paller/hat/wemos hat.kicad_pcb

## KiCad design wemos hat.kicad_pcb (2019-12-09)

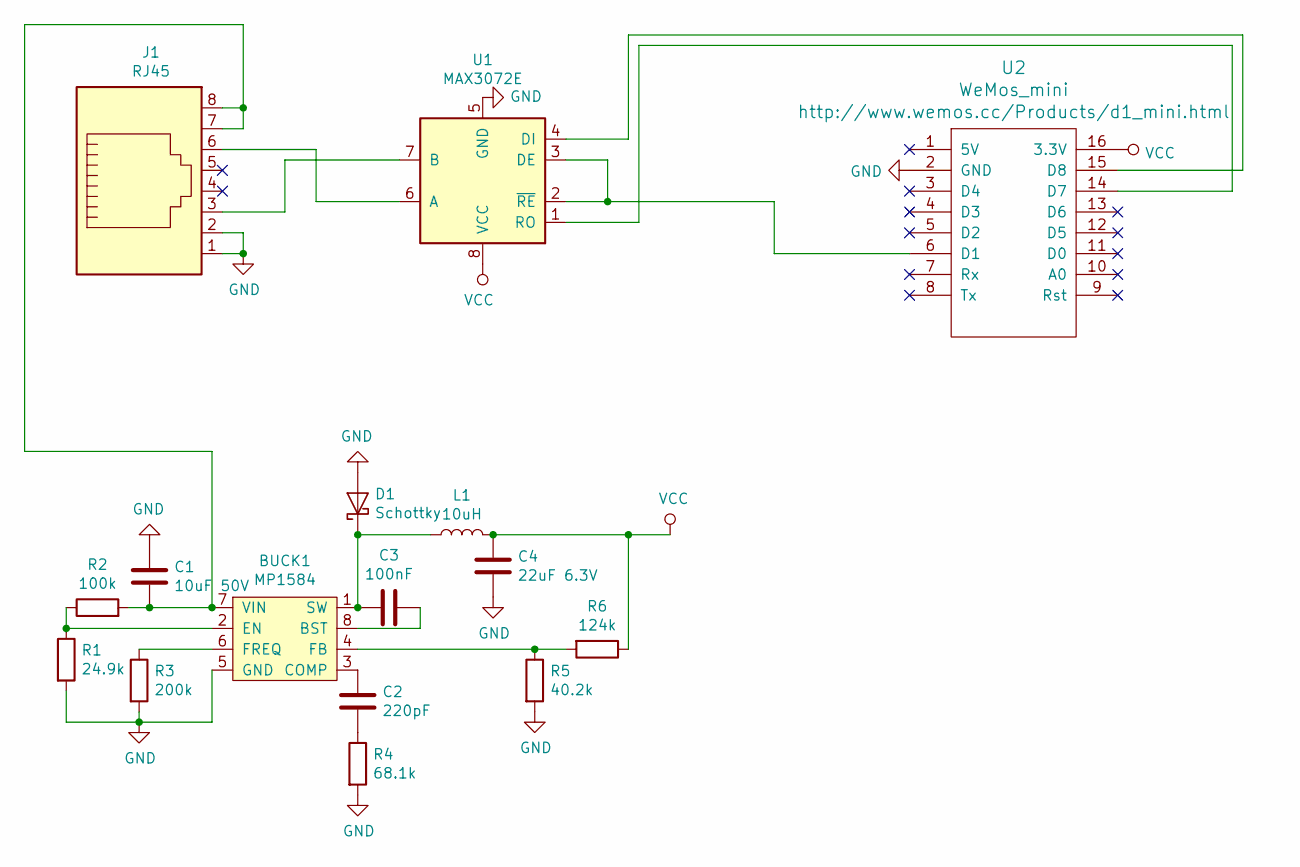
[picture p1: schematic wemos hat.sch]

Parts:
BUCK1: MP1584; SOIC-8_3.9x4.9mm_P1.27mm
C1: 10uF 50V; C_1206_3216Metric
C2: 220pF; C_0603_1608Metric
C3: 100nF; C_0603_1608Metric
C4: 22uF 6.3V; C_0603_1608Metric
D1: Schottky; D_SMA
J1: RJ45; RJ45_Amphenol_54602-x08_Horizontal
L1: 10uH; L_Sunlord_MWSA0518_5.4x5.2mm
R1: 24.9k; R_0603_1608Metric
R2: 100k; R_0603_1608Metric
R3: 200k; R_0603_1608Metric
R4: 68.1k; R_0603_1608Metric
R5: 40.2k; R_0603_1608Metric
R6: 124k; R_0603_1608Metric
U1: MAX3072E; SOIC-8_3.9x4.9mm_P1.27mm
U2: WeMos_mini; wemos-d1-mini-connectors-only

Connections:
GND: BUCK1.5 (GND), C1.1, C4.2, D1.2 (A), J1.1, J1.2, R1.2, R3.2, R4.2, R5.2, U1.5 (GND), U2.2 (GND)
unnamed: BUCK1.1 (SW), C3.2, D1.1 (K), L1.1
unnamed: BUCK1.2 (EN), R1.1, R2.1
unnamed: BUCK1.3 (COMP), C2.1
unnamed: BUCK1.4 (FB), R5.1, R6.2
unnamed: BUCK1.6 (FREQ), R3.1
unnamed: BUCK1.7 (VIN), C1.2, J1.7, J1.8, R2.2
unnamed: BUCK1.8 (BST), C3.1
unnamed: C2.2, R4.1
unnamed: J1.3, U1.7 (B)
unnamed: J1.6, U1.6 (A)
unnamed: U1.1 (RO), U2.14 (D7)
unnamed: U1.2 (~RE~), U1.3 (DE), U2.6 (D1)
unnamed: U1.4 (DI), U2.15 (D8)
VCC: C4.1, L1.2, R6.1, U1.8 (VCC), U2.16 (3.3V)

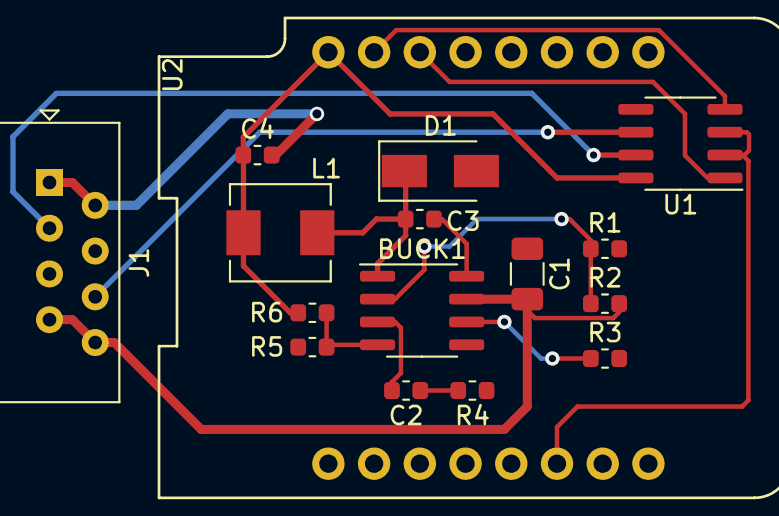
[picture p2: board wemos hat.kicad_pcb from above]

Board: 2 copper layers, 16 parts (0 on the bottom side), 15 nets.
