paller/hat/(commit log)

2019-12-08 Something new
    [wemos hat.kicad_pcb, wemos hat.sch]
2019-12-09 Components done
    [wemos hat.kicad_pcb, wemos hat.sch]
